Dahlia-Dry/teg-datalogger/documentation/teg-datalogger-v0-1.png

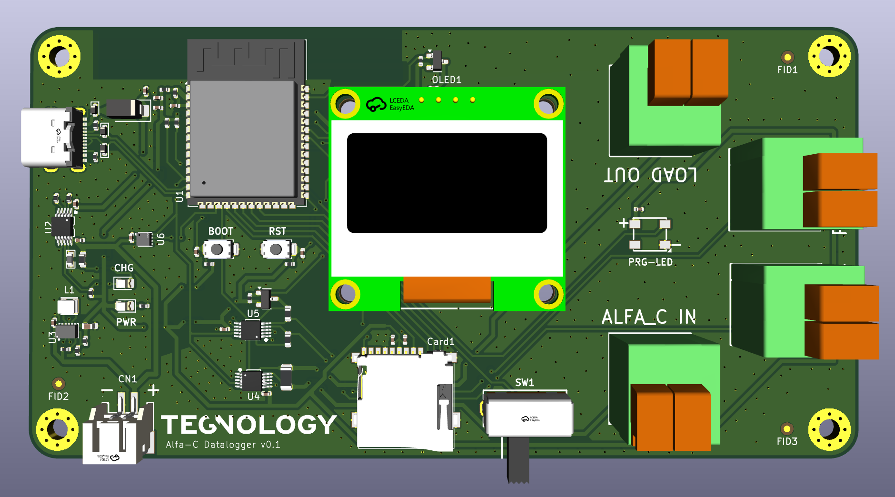
documentation/teg-datalogger-v0-1.png
