Dahlia-Dry/teg-datalogger/documentation/teg-datalogger-v0-1.pdf

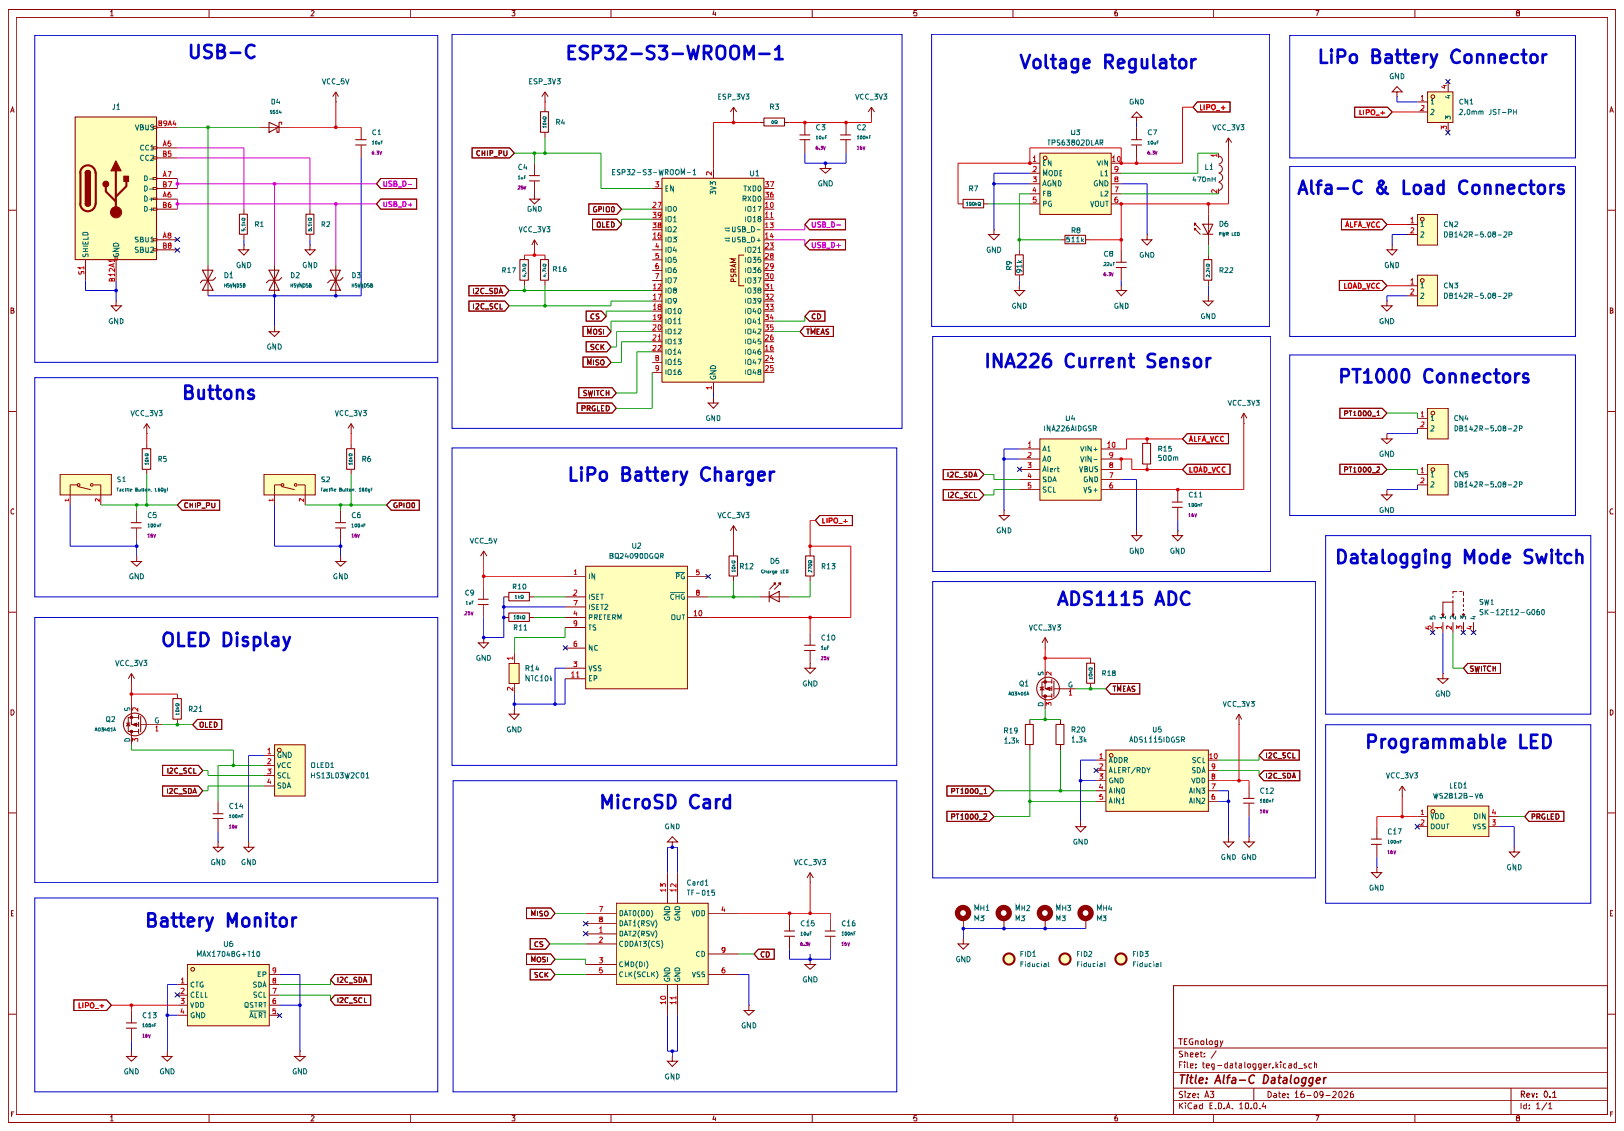
[picture p2: page 1]
