Dahlia-Dry/teg-datalogger/teg-datalogger.kicad_pcb

## KiCad design teg-datalogger.kicad_pcb (2026-10-22)

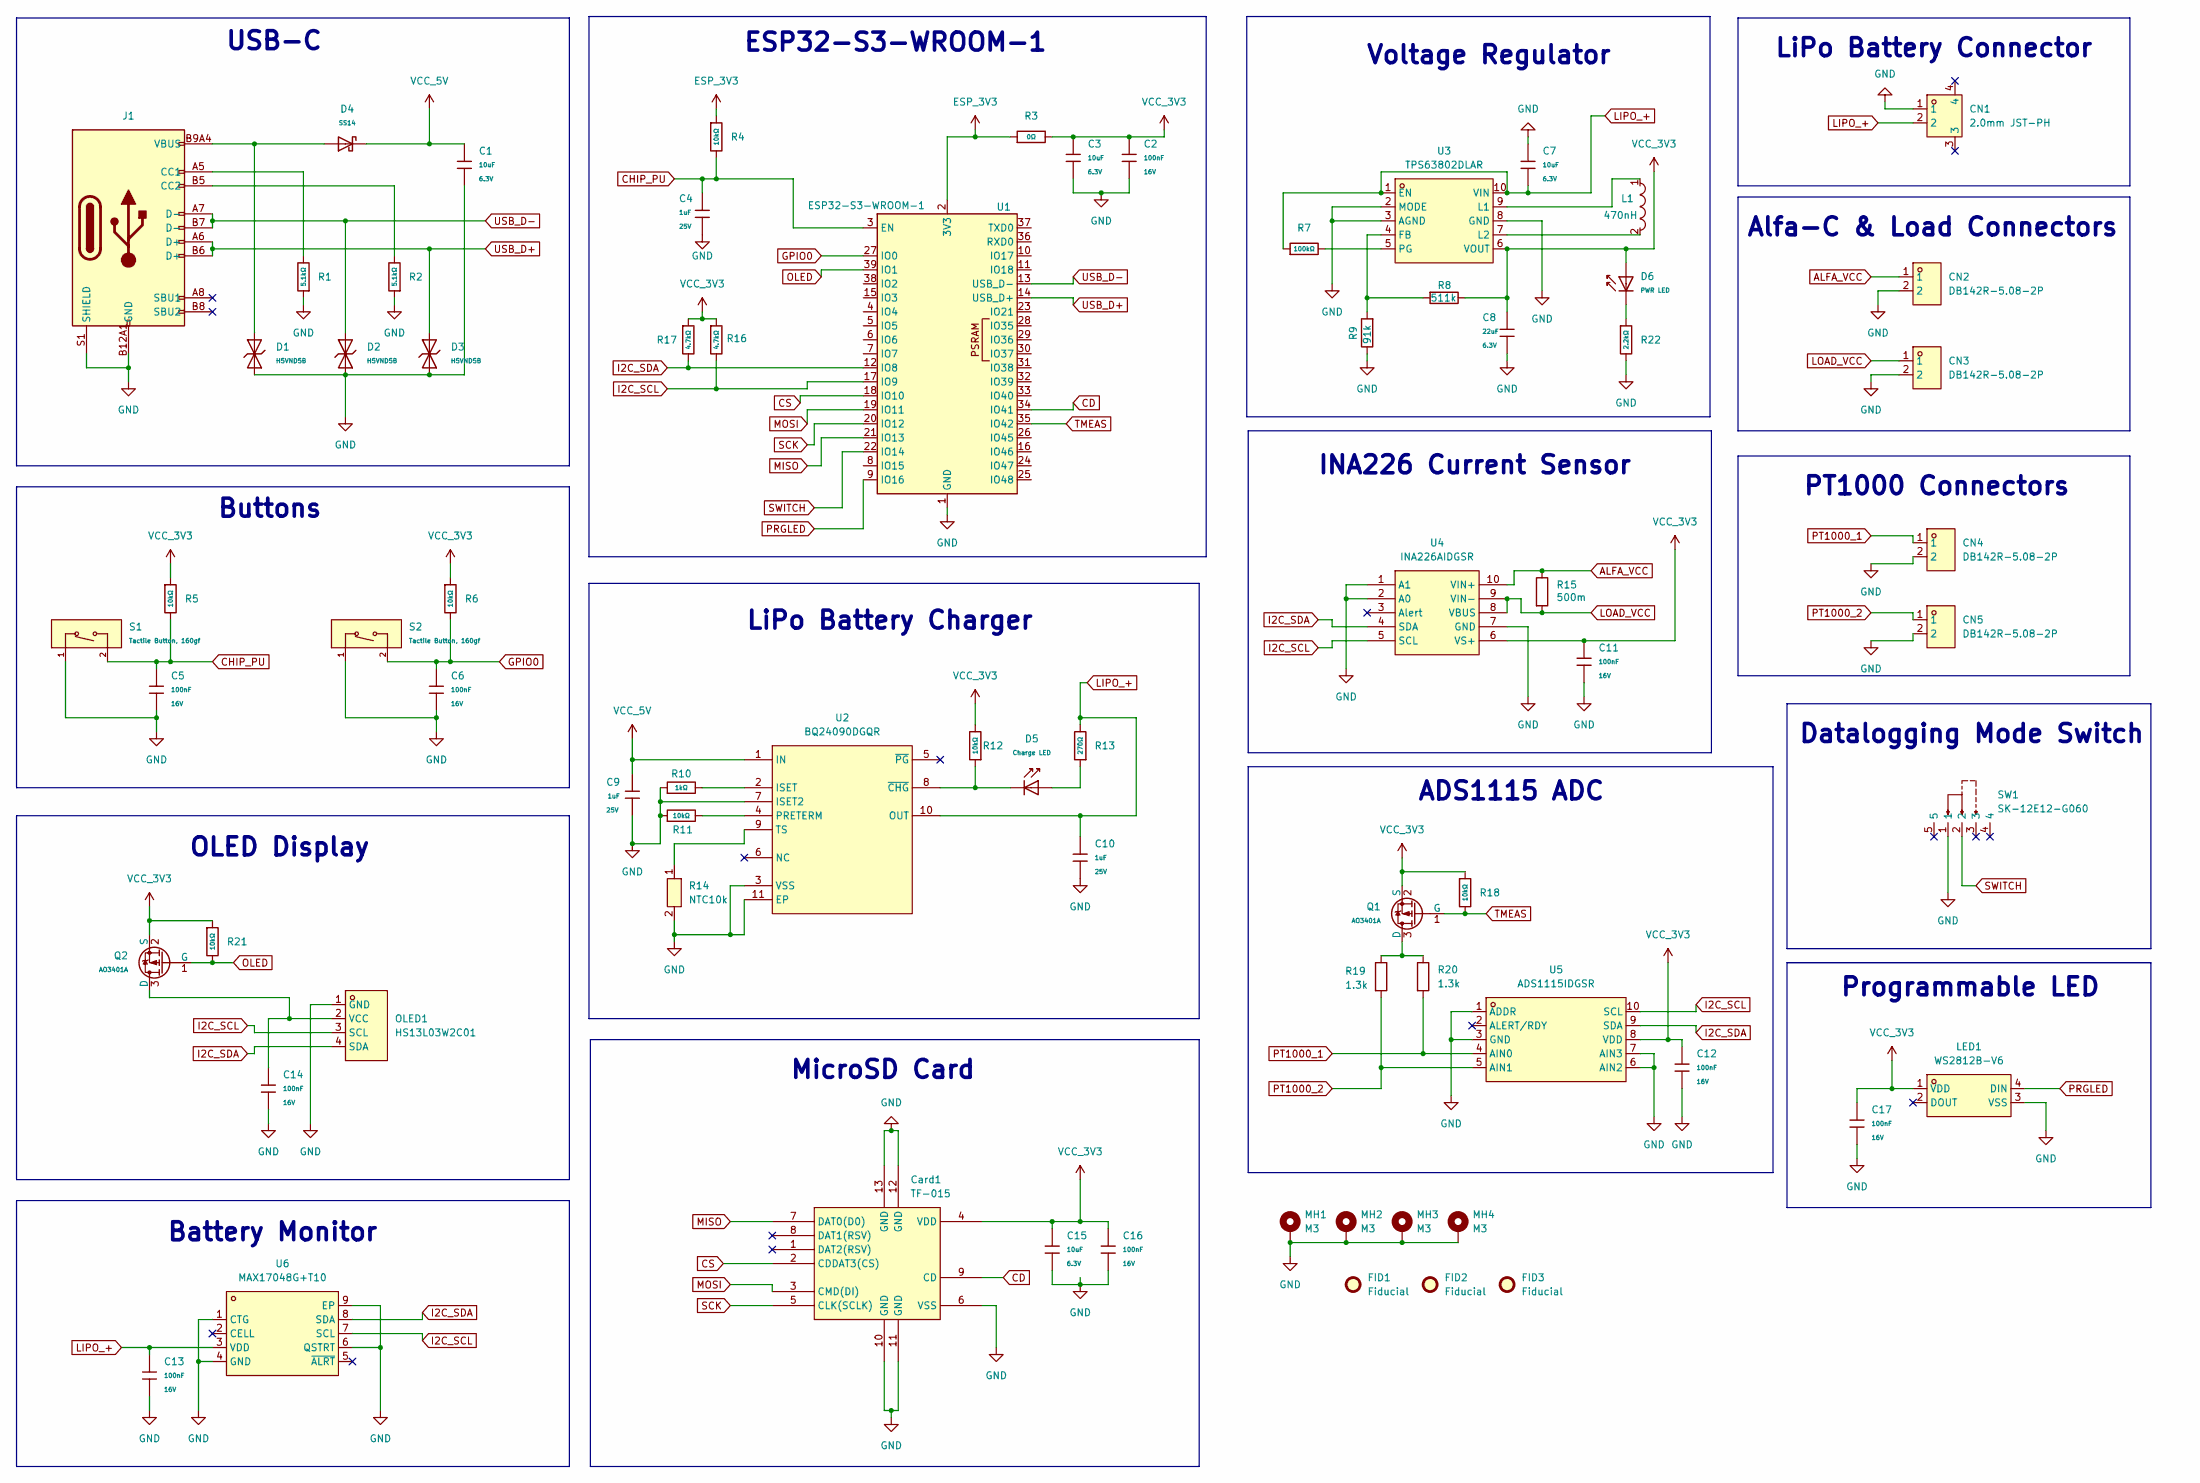
[picture p3: schematic teg-datalogger.kicad_sch, Alfa-C Datalogger]

Parts:
C1, C3, C7, C15: 10uF; C_0402; Voltage Rated 6.3V; Tolerance ±20%; Part CL05A106MQ5NUNC; LCSC C15525
C2, C5, C6, C11, C12, C13, C14, C16, C17: 100nF; C_0402; Voltage Rated 16V; Tolerance ±10%; Part CL05B104KO5NNNC; LCSC C1525
C4, C9, C10: 1uF; C_0402; Voltage Rated 25V; Tolerance ±10%; Part CL05A105KA5NQNC; LCSC C52923
C8: 22uF; C_0603; Voltage Rated 6.3V; Tolerance ±20%; Part CL10A226MQ8NRNC; LCSC C59461
CN1: 2.0mm JST-PH; CONN-SMD_P2.00_S2B-PH-SM4-TB-LF-SN; MPN S2B-PH-SM4-TB(LF)(SN); LCSC Part C295747
CN2, CN3, CN4, CN5: DB142R-5.08-2P; CONN-TH_2P-P5.08_DIBO_DB142R-5.08-2P; MPN DB142R-5.08-2P-GN; LCSC C2898709
Card1: TF-015; TF-SMD_TF-015; MPN TF-015; LCSC C113206
D1, D2, D3: H5VND5B; D_SOD-523; Part H5VND5B; LCSC C20615818
D4: SS14; D_SMA; Forward Voltage (Vf@If) 550mV@1A; Reverse Voltage (Vr) 40V; Part SS14; LCSC C2480
D5: Charge LED; D_0805; Forward Voltage (VF) 1.6V~2.6V; Part NCD0805R1; LCSC C84256
D6: PWR LED; D_0805; Forward Voltage (VF) 1.6V~2.6V; Part NCD0805R1; LCSC C84256
FID1, FID2, FID3: Fiducial; Fiducial_1mm_Mask2mm
J1: Connector, USB-TYPE-C-16P; TYPE-C-SMD_HX-TYPE-C-16PIN; LCSC C2927039
L1: 470nH; IND-SMD_L2.5-W2.0_VLS252010HBX; MPN VLS252010HBX-R47M-1; LCSC Part C88530
LED1: WS2812B-V6; LED-SMD_4P-L5.0-W5.0-TL-A; MPN WS2812B-V6; LCSC C52917433
MH1, MH2, MH3, MH4: M3; MountingHole_3.2mm_M3_Pad_Via
OLED1: HS13L03W2C01; OLED-TH_L35.4-W33.5_HS13L03W2C01; MPN HS13L03W2C01; LCSC C7465997
Q1, Q2: AO3401A; Q_SOT-23; Part AO3401A; LCSC C15127
R1, R2: 5.1kΩ; R_0402; Overload Voltage (Max) 50V; Tolerance ±1%; Part 0402WGF5101TCE; LCSC C25905
R3: 0Ω; R_0402; Overload Voltage (Max) 50V; Tolerance ±1%; Part 0402WGF0000TCE; LCSC C17168
R4, R5, R6, R11, R12, R18, R21: 10kΩ; R_0402; Overload Voltage (Max) 50V; Tolerance ±1%; Part 0402WGF1002TCE; LCSC C25744
R7: 100kΩ; R_0402; Overload Voltage (Max) 50V; Tolerance ±1%; Part 0402WGF1003TCE; LCSC C25741
R8: 511k; R_0402; LCSC C5126239
R9: 91k; R_0402; LCSC C60490
R10: 1kΩ; R_0402; Overload Voltage (Max) 50V; Tolerance ±1%; Part 0402WGF1001TCE; LCSC C11702
R13: 270Ω; R_0603; Overload Voltage (Max) 75V; Tolerance ±1%; Part 0603WAF2700T5E; LCSC C22966
R14: NTC10k; R0603; MPN NTCG163JF103HT1; LCSC Part C531304
R15: 500m; R_1206; LCSC C346764
R16, R17: 4.7kΩ; R_0402; Overload Voltage (Max) 50V; Tolerance ±1%; Part 0402WGF4701TCE; LCSC C25900
R19, R20: 1.3k; R_0603; LCSC C860193
R22: 2.2kΩ; R_0402; Overload Voltage (Max) 50V; Tolerance ±1%; Part 0402WGF2201TCE; LCSC C25879
S1, S2: Tactile Button, 160gf; SW_TS-1088-AR02016; Voltage Rating (Dc) 12V; Part TS-1088-AR02016; LCSC C720477
SW1: SK-12E12-G060; SW-TH_SK-12E12-G070; MPN SK-12E12-G060; LCSC C22448008
U1: ESP32-S3-WROOM-1; LCSC C2913202
U2: BQ24090DGQR; MSOP-10_L3.0-W3.0-P0.50-LS5.0-BL-EP; MPN BQ24090DGQR; LCSC C43306
U3: TPS63802DLAR; VSON-10_L3.0-W2.0-P0.50-TL; MPN TPS63802DLAR; LCSC C2845237
U4: INA226AIDGSR; MSOP-10_L3.0-W3.0-P0.50-LS5.0-BL; MPN INA226AIDGSR; LCSC Part C49851
U5: ADS1115IDGSR; MSOP-10_L3.0-W3.0-P0.50-LS5.0-BL; MPN ADS1115IDGSR; LCSC C37593
U6: MAX17048G+T10; TDFN-8_L2.0-W2.0-P0.50-BL-EP1.2; MPN MAX17048G+T10; LCSC C2682616

Connections:
ALFA_VCC: CN2.1, R15.1, U4.10 (VIN+)
CD: Card1.9 (CD), U1.34 (IO41)
CHIP_PU: C4.2, C5.1, R4.2, R5.2, S1.2 (B), U1.3 (EN)
CS: Card1.2 (CDDAT3(CS)), U1.18 (IO10)
ESP_3V3: R3.1, R4.1, U1.2 (3V3)
GND: C1.2, C2.2, C3.2, C4.1, C5.2, C6.2, C7.1, C8.1, C9.2, C10.2, C11.2, C12.2, C13.2, C14.2, C15.2, C16.2, C17.2, CN1.1, CN2.2, CN3.2, CN4.2, CN5.2, Card1.6 (VSS), Card1.10 (GND), Card1.11 (GND), Card1.12 (GND), Card1.13 (GND), D1.1, D2.1, D3.1, J1.A12B1 (GND), J1.B12A1 (GND), J1.S1 (SHIELD), LED1.3 (VSS), MH1.1 (1_1), MH2.1 (1_1), MH3.1 (1_1), MH4.1 (1_1), OLED1.1 (GND), R1.1, R2.1, R9.1, R10.1, R11.1, R14.2, R22.2, S1.1 (A), S2.1 (A), SW1.1, U1.1 (GND), U1.40 (GND), U1.41 (GND), U2.3 (VSS), U2.7 (ISET2), U2.11 (EP), U3.2 (MODE), U3.3 (AGND), U3.8 (GND), U4.1 (A1), U4.2 (A0), U4.7 (GND), U5.1 (ADDR), U5.3 (GND), U5.6 (AIN2), U5.7 (AIN3), U6.1 (CTG), U6.4 (GND), U6.6 (QSTRT), U6.9 (EP)
GPIO0: C6.1, R6.2, S2.2 (B), U1.27 (IO0)
I2C_SCL: OLED1.3 (SCL), R16.2, U1.17 (IO9), U4.5 (SCL), U5.10 (SCL), U6.7 (SCL)
I2C_SDA: OLED1.4 (SDA), R17.2, U1.12 (IO8), U4.4 (SDA), U5.9 (SDA), U6.8 (SDA)
LIPO_+: C7.2, C10.1, C13.1, CN1.2, R7.1, R13.2, U2.10 (OUT), U3.1 (EN), U3.10 (VIN), U6.3 (VDD)
LOAD_VCC: CN3.1, R15.2, U4.8 (VBUS), U4.9 (VIN-)
MISO: Card1.7 (DAT0(D0)), U1.21 (IO13)
MOSI: Card1.3 (CMD(DI)), U1.19 (IO11)
unnamed: D1.2, D4.2, J1.A9B4 (VBUS), J1.B9A4 (VBUS)
unnamed: D5.2, R13.1
unnamed: D6.1, R22.1
unnamed: J1.A5 (CC1), R1.2
unnamed: J1.B5 (CC2), R2.2
unnamed: C14.1, OLED1.2 (VCC), Q2.3 (D)
unnamed: Q1.3 (D), R19.1, R20.1
unnamed: R10.2, U2.2 (ISET)
unnamed: R11.2, U2.4 (PRETERM)
unnamed: R14.1, U2.9 (TS)
unnamed: D5.1, R12.1, U2.8 (~CHG)
unnamed: R8.2, R9.2, U3.4 (FB)
unnamed: L1.1, U3.9 (L1)
unnamed: L1.2, U3.7 (L2)
unnamed: R7.2, U3.5 (PG)
OLED: Q2.1 (G), R21.2, U1.39 (IO1)
PRGLED: LED1.4 (DIN), U1.9 (IO16)
PT1000_1: CN4.1, R20.2, U5.4 (AIN0)
PT1000_2: CN5.1, R19.2, U5.5 (AIN1)
SCK: Card1.5 (CLK(SCLK)), U1.20 (IO12)
SWITCH: SW1.2, U1.22 (IO14)
TMEAS: Q1.1 (G), R18.2, U1.35 (IO42)
USB_D+: D3.2, J1.A6 (D+), J1.B6 (D+), U1.14 (USB_D+)
USB_D-: D2.2, J1.A7 (D-), J1.B7 (D-), U1.13 (USB_D-)
VCC_3V3: C2.1, C3.1, C8.2, C11.1, C12.1, C15.1, C16.1, C17.1, Card1.4 (VDD), D6.2, LED1.1 (VDD), Q1.2 (S), Q2.2 (S), R3.2, R5.1, R6.1, R8.1, R12.2, R16.1, R17.1, R18.1, R21.1, U3.6 (VOUT), U4.6 (VS+), U5.8 (VDD)
VCC_5V: C1.1, C9.1, D4.1, U2.1 (IN)

Notes on the sheet:
Buttons
INA226 Current Sensor
Voltage Regulator
Battery Monitor
PT1000 Connectors
Programmable LED
OLED Display
ESP32-S3-WROOM-1
MicroSD Card
LiPo Battery Connector
LiPo Battery Charger
Datalogging Mode Switch
Alfa-C & Load Connectors
USB-C
ADS1115 ADC

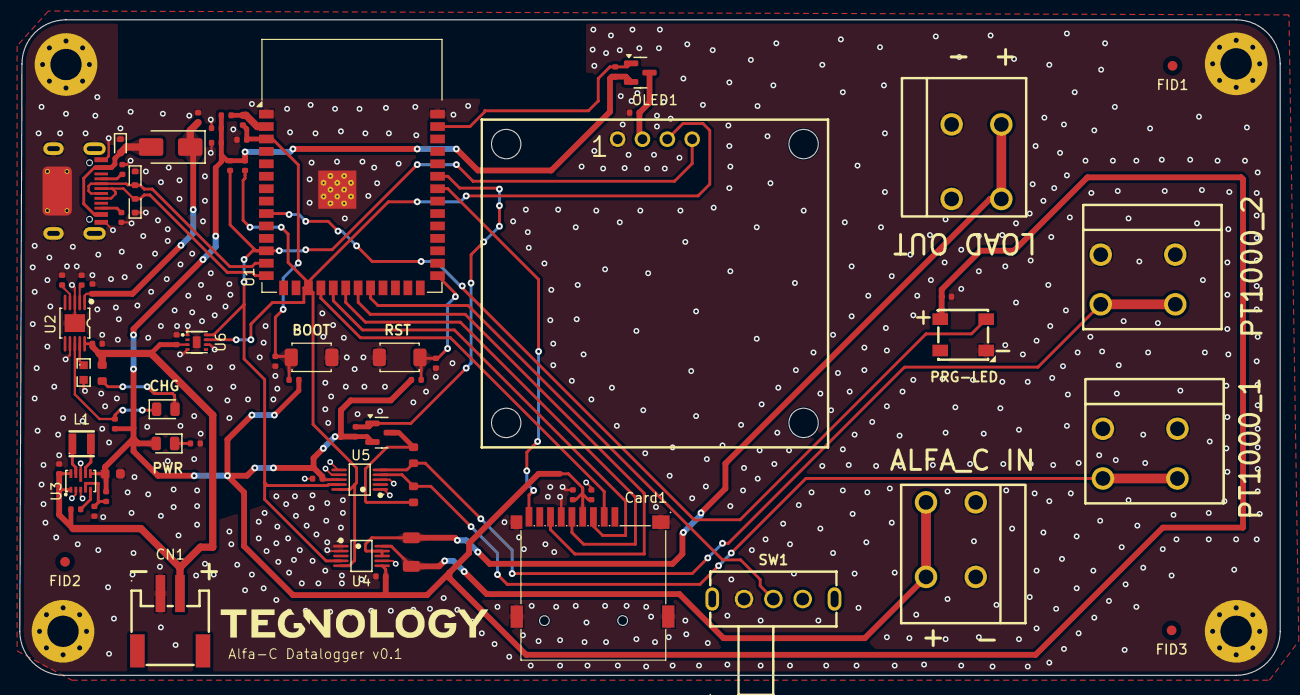
[picture p4: board teg-datalogger.kicad_pcb from above]

Board: 2 copper layers, 128.8 x 67.0 mm, 73 parts (0 on the bottom side), 39 nets.
