Dahlia-Dry/teg-datalogger/(commit log)

2026-10-22 first commit: adding prototype
    [AlfaC_Datalogger_v0-1_bom.csv, AlfaC_Datalogger_v0-1_designators.csv, AlfaC_Datalogger_v0-1_positions.csv, BOM-teg-datalogger.csv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]
2026-10-22 add kicad gitignore and untrack generated files
    [AlfaC_Datalogger_v0-1_bom.csv, AlfaC_Datalogger_v0-1_designators.csv, AlfaC_Datalogger_v0-1_positions.csv, BOM-teg-datalogger.csv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]
